pwbrophy/thundergeddon-kicad/TankHull/3d_models/MP2228GJ-Z.step

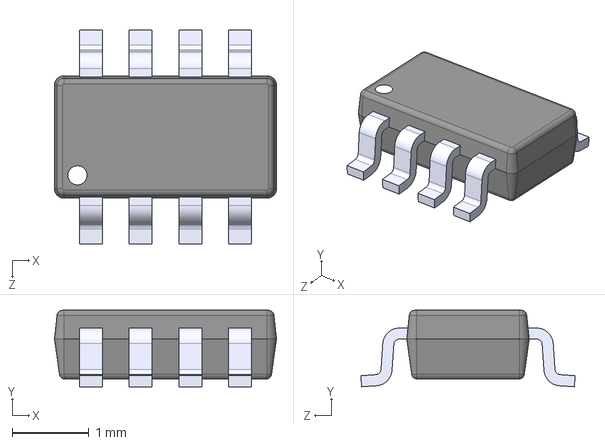
[picture p1: CAD file, 2026-01-02]
TankHull/3d_models/MP2228GJ-Z.step
2.90 x 1.00 x 2.80 mm
