pwbrophy/thundergeddon-kicad/TankHull/TankHull.step

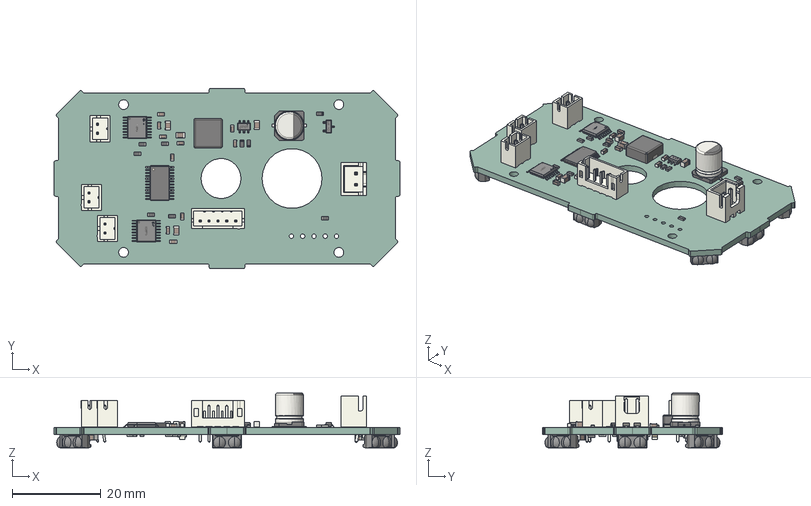
[picture p2: CAD file, 2026-03-31]
TankHull/TankHull.step
77.9 x 40.6 x 12.4 mm
JST_XH_B2B-XH-A_1x02_P2.50mm_Vertical
R_0603_1608Metric x 28
C_0805_2012Metric x 12
C_0603_1608Metric x 18
JST_PH_B2B-PH-K_1x02_P2.00mm_Vertical x 3
TSOT-23-6_L2.9-W1.6-H1.1-LS2.8-P0.95
SOT-23-3P_L2.9-W1.3-H1.0-LS2.4-P0.95
TSSOP-16_L5.0-W4.4-H1.0-LS6.4-P0.65 x 2
TSSOP-24_4.4x7.8mm_P0.65mm
JST_PH_B5B-PH-K_1x05_P2.00mm_Vertical
CP_Elec_6.3x7.7
L_Changjiang_FXL0630
IRM-V838M3_TR1 x 8
LED_0805_2012Metric
D_0603_1608Metric
TankHull_PCB
