pwbrophy/thundergeddon-kicad/TankHull/TankHull.kicad_pcb

## KiCad design TankHull/TankHull.kicad_pcb (2026-03-15)

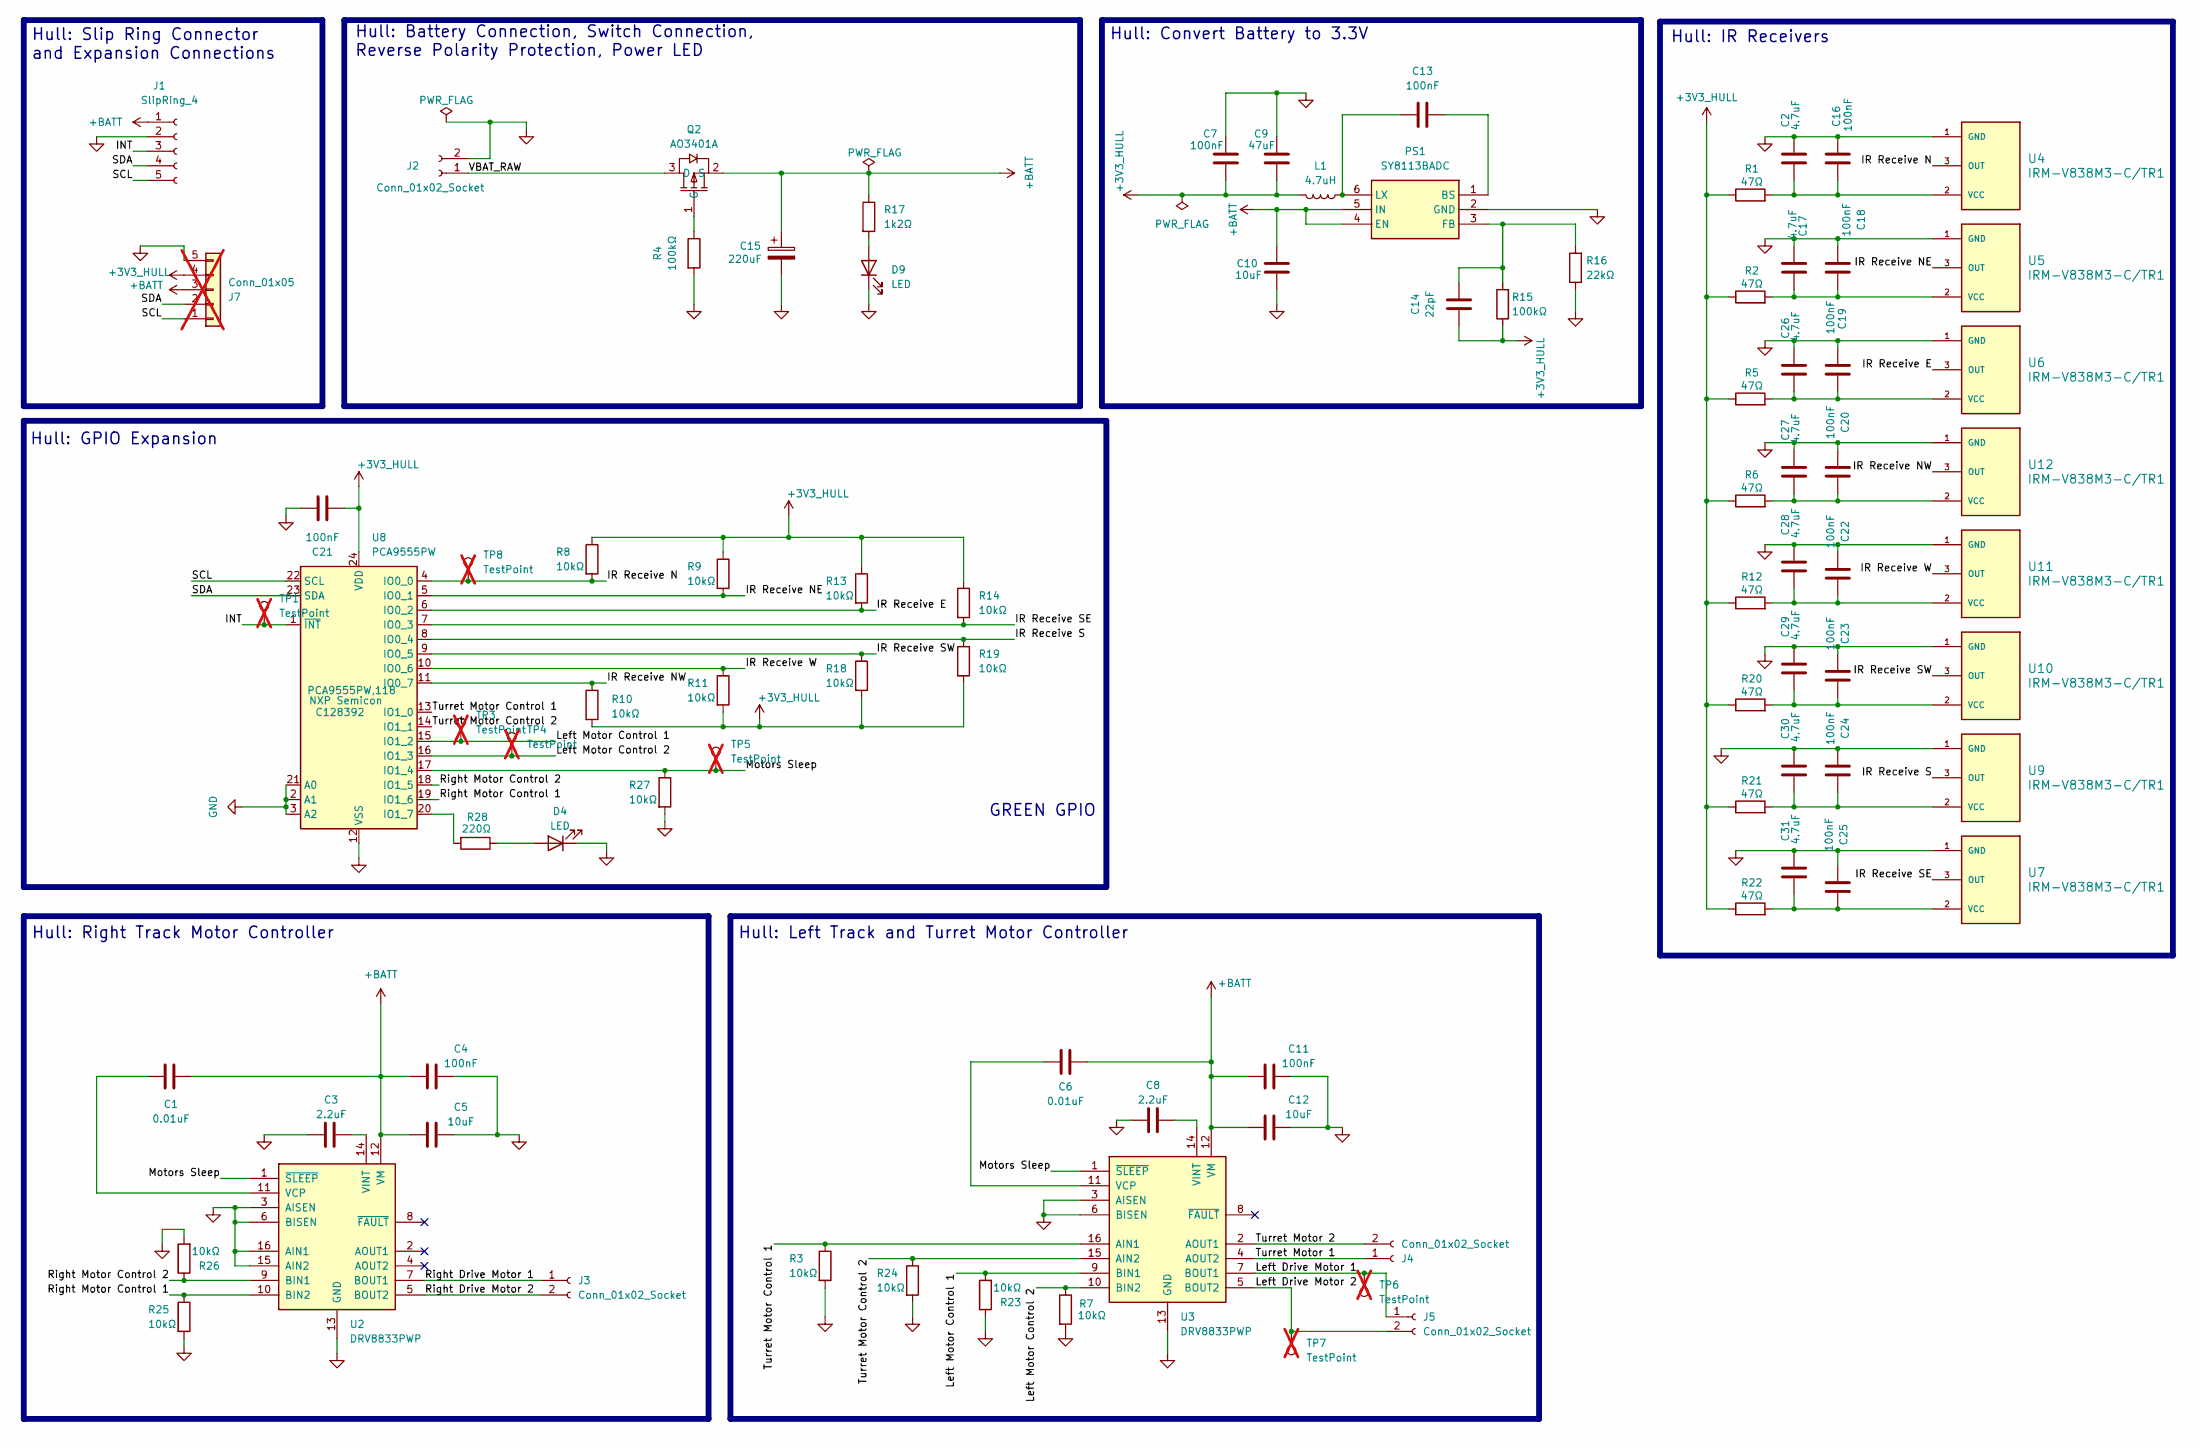
[picture p4: schematic TankHull.kicad_sch, Tank Hull Board]

Parts:
C1, C6: 0.01uF; C_0603_1608Metric; Manufacturer_Part_Number 0603B103K500NT; JLCPCB Part # C57112
C2, C17, C26, C27, C28, C29, C30, C31: 4.7uF; C_0805_2012Metric; JLCPCB Part # C1779
C3, C8: 2.2uF; C_0603_1608Metric; Manufacturer_Part_Number CL10A225KO8NNNC; JLCPCB Part # C23630
C4, C7, C11, C13, C16, C18, C19, C20, C21, C22, C23, C24, C25: 100nF; C_0603_1608Metric; Manufacturer_Part_Number CC0603KRX7R9BB104; JLCPCB Part # C14663
C5, C10, C12: 10uF; C_0805_2012Metric; Manufacturer_Part_Number CL21A106KAYNNNE; JLCPCB Part # C15850
C9: 47uF; C_0805_2012Metric; Manufacturer_Part_Number C16780; JLCPCB Part # C16780
C14: 22pF; C_0603_1608Metric; Manufacturer_Part_Number CL10C220JB8NNNC; JLCPCB Part # C1653
C15: 220uF; CP_Elec_6.3x7.7; Manufacturer_Part_Number RVT220UF16V67RV0015; JLCPCB Part # C2887273
D4: LED; LED_0805_2012Metric; JLCPCB Part # C2297
D9: LED; D_0603_1608Metric; Manufacturer_Part_Number KT-0603R; JLCPCB Part # C2286
J1: SlipRing_4; JST_PH_B5B-PH-K_1x05_P2.00mm_Vertical; JLCPCB Part # C157993
J2: Conn_01x02_Socket; JST_XH_B2B-XH-A_1x02_P2.50mm_Vertical; Manufacturer_Part_Number B2B-XH-A(LF)(SN); JLCPCB Part # C158012
J3, J4, J5: Conn_01x02_Socket; JST_PH_B2B-PH-K_1x02_P2.00mm_Vertical; Manufacturer_Part_Number B2B-PH-K-S(LF)(SN); JLCPCB Part # C131337
J7: Conn_01x05; PinSocket_1x05_P2.54mm_Vertical; Manufacturer_Part_Number 2.54-1*5PFemale; JLCPCB Part # C50950; not fitted
L1: 4.7uH; L_Changjiang_FXL0630; Manufacturer_Part_Number FXL0630-4R7-M; JLCPCB Part # C167220
PS1: SY8113BADC; SOT95P285X100-6N; Manufacturer_Part_Number SY8113BADC; JLCPCB Part # C78989
Q2: AO3401A; SOT-23_L2.9-W1.3-P1.90-LS2.4-BR; JLCPCB Part # C15127
R1, R2, R5, R6, R12, R20, R21, R22: 47Ω; R_0603_1608Metric; JLCPCB Part # C23182
R3, R7, R8, R9, R10, R11, R13, R14, R18, R19, R23, R24, R25, R26, R27: 10kΩ; R_0603_1608Metric; Manufacturer_Part_Number 0603WAF1002T5E; JLCPCB Part # C25804
R4, R15: 100kΩ; R_0603_1608Metric; Manufacturer_Part_Number 0603WAF1003T5E; JLCPCB Part # C25803
R16: 22kΩ; R_0603_1608Metric; Manufacturer_Part_Number 0603WAF2202T5E; JLCPCB Part # C31850
R17: 1k2Ω; R_0603_1608Metric; Manufacturer_Part_Number 0603WAF1201T5E; JLCPCB Part # C22765
R28: 220Ω; R_0603_1608Metric; JLCPCB Part # C22962
TP1, TP3, TP4, TP5, TP6, TP7, TP8: TestPoint; TestPoint_Pad_D1.0mm; not fitted
U2, U3: DRV8833PWP; HTSSOP-16-1EP_4.4x5mm_P0.65mm_EP3.4x5mm_Mask2.46x2.31mm_The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; Manufacturer_Part_Number DRV8833PWPR; JLCPCB Part # C50506
U4, U5, U6, U7, U9, U10, U11, U12: IRM-V838M3-C/TR1; XDCR_IRM-V838M3_TR1; PARTREV 7; JLCPCB Part # C3291489
U8: PCA9555PW; TSSOP-24_4.4x7.8mm_P0.65mm; Manufacturer_Part_Number PCA9555PW,118; JLCPCB Part # C128392

Connections:
+3V3_HULL: C7.1, C9.1, C14.2, C21.2, J7.4, L1.2, R1.1, R2.1, R5.1, R6.1, R8.1, R9.1, R10.2, R11.2, R12.1, R13.1, R14.1, R15.1, R18.2, R19.2, R20.1, R21.1, R22.1, U8.24 (VDD)
+BATT: C1.1, C4.2, C5.2, C6.1, C10.2, C11.2, C12.2, C15.1, J1.1, J7.3, PS1.4 (EN), PS1.5 (IN), Q2.2 (S), R17.1, U2.12 (VM), U3.12 (VM)
/INT: J1.3, TP1.1, U8.1 (~INT)
/IR Receive E: R13.2, U6.3 (OUT), U8.6 (IO0_2)
/IR Receive N: R8.2, TP8.1, U4.3 (OUT), U8.4 (IO0_0)
/IR Receive NE: R9.2, U5.3 (OUT), U8.5 (IO0_1)
/IR Receive NW: R10.1, U8.11 (IO0_7), U12.3 (OUT)
/IR Receive S: R19.1, U8.8 (IO0_4), U9.3 (OUT)
/IR Receive SE: R14.2, U7.3 (OUT), U8.7 (IO0_3)
/IR Receive SW: R18.1, U8.9 (IO0_5), U10.3 (OUT)
/IR Receive W: R11.1, U8.10 (IO0_6), U11.3 (OUT)
/Left Drive Motor 1: J5.1, TP6.1, U3.7 (BOUT1)
/Left Drive Motor 2: J5.2, TP7.1, U3.5 (BOUT2)
/Left Motor Control 1: R23.2, TP3.1, U3.9 (BIN1), U8.15 (IO1_2)
/Left Motor Control 2: R7.1, TP4.1, U3.10 (BIN2), U8.16 (IO1_3)
/Motors Sleep: R27.1, TP5.1, U2.1 (~SLEEP), U3.1 (~SLEEP), U8.17 (IO1_4)
/Right Drive Motor 1: J3.1, U2.7 (BOUT1)
/Right Drive Motor 2: J3.2, U2.5 (BOUT2)
/Right Motor Control 1: R25.1, U2.10 (BIN2), U8.19 (IO1_6)
/Right Motor Control 2: R26.1, U2.9 (BIN1), U8.18 (IO1_5)
/SCL: J1.5, J7.1, U8.22 (SCL)
/SDA: J1.4, J7.2, U8.23 (SDA)
/Turret Motor 1: J4.1, U3.4 (AOUT2)
/Turret Motor 2: J4.2, U3.2 (AOUT1)
/Turret Motor Control 1: R3.1, U3.16 (AIN1), U8.13 (IO1_0)
/Turret Motor Control 2: R24.1, U3.15 (AIN2), U8.14 (IO1_1)
/VBAT_RAW: J2.1, Q2.3 (D)
GND: C2.1, C3.1, C4.1, C5.1, C7.2, C8.1, C9.2, C10.1, C11.1, C12.1, C15.2, C16.1, C17.1, C18.1, C19.1, C20.1, C21.1, C22.1, C23.1, C24.1, C25.1, C26.1, C27.1, C28.1, C29.1, C30.1, C31.1, D4.1 (K), D9.1 (K), J1.2, J2.2, J7.5, PS1.2 (GND), R3.2, R4.2, R7.2, R16.1, R23.1, R24.2, R25.2, R26.2, R27.2, U2.3 (AISEN), U2.6 (BISEN), U2.13 (GND), U2.15 (AIN2), U2.16 (AIN1), U2.17 (GND), U3.3 (AISEN), U3.6 (BISEN), U3.13 (GND), U3.17 (GND), U4.1 (GND), U4.4 (GND), U5.1 (GND), U5.4 (GND), U6.1 (GND), U6.4 (GND), U7.1 (GND), U7.4 (GND), U8.2 (A1), U8.3 (A2), U8.12 (VSS), U8.21 (A0), U9.1 (GND), U9.4 (GND), U10.1 (GND), U10.4 (GND), U11.1 (GND), U11.4 (GND), U12.1 (GND), U12.4 (GND)
unnamed: D4.2 (A), R28.1
unnamed: D9.2 (A), R17.2
unnamed: C13.1, PS1.1 (BS)
unnamed: C14.1, PS1.3 (FB), R15.2, R16.2
unnamed: C13.2, L1.1, PS1.6 (LX)
unnamed: Q2.1 (G), R4.1
unnamed: C1.2, U2.11 (VCP)
unnamed: C3.2, U2.14 (VINT)
unnamed: C6.2, U3.11 (VCP)
unnamed: C8.2, U3.14 (VINT)
unnamed: C2.2, C16.2, R1.2, U4.2 (VCC)
unnamed: C17.2, C18.2, R2.2, U5.2 (VCC)
unnamed: C19.2, C26.2, R5.2, U6.2 (VCC)
unnamed: C25.2, C31.2, R22.2, U7.2 (VCC)
unnamed: R28.2, U8.20 (IO1_7)
unnamed: C24.2, C30.2, R21.2, U9.2 (VCC)
unnamed: C23.2, C29.2, R20.2, U10.2 (VCC)
unnamed: C22.2, C28.2, R12.2, U11.2 (VCC)
unnamed: C20.2, C27.2, R6.2, U12.2 (VCC)

Notes on the sheet:
GREEN GPIO
Hull: Left Track and Turret Motor Controller
Hull: Convert Battery to 3.3V
Hull: Slip Ring Connector and Expansion Connections
Hull: IR Receivers
Hull: Battery Connection, Switch Connection, Reverse Polarity Protection, Power LED
Hull: GPIO Expansion
Hull: Right Track Motor Controller

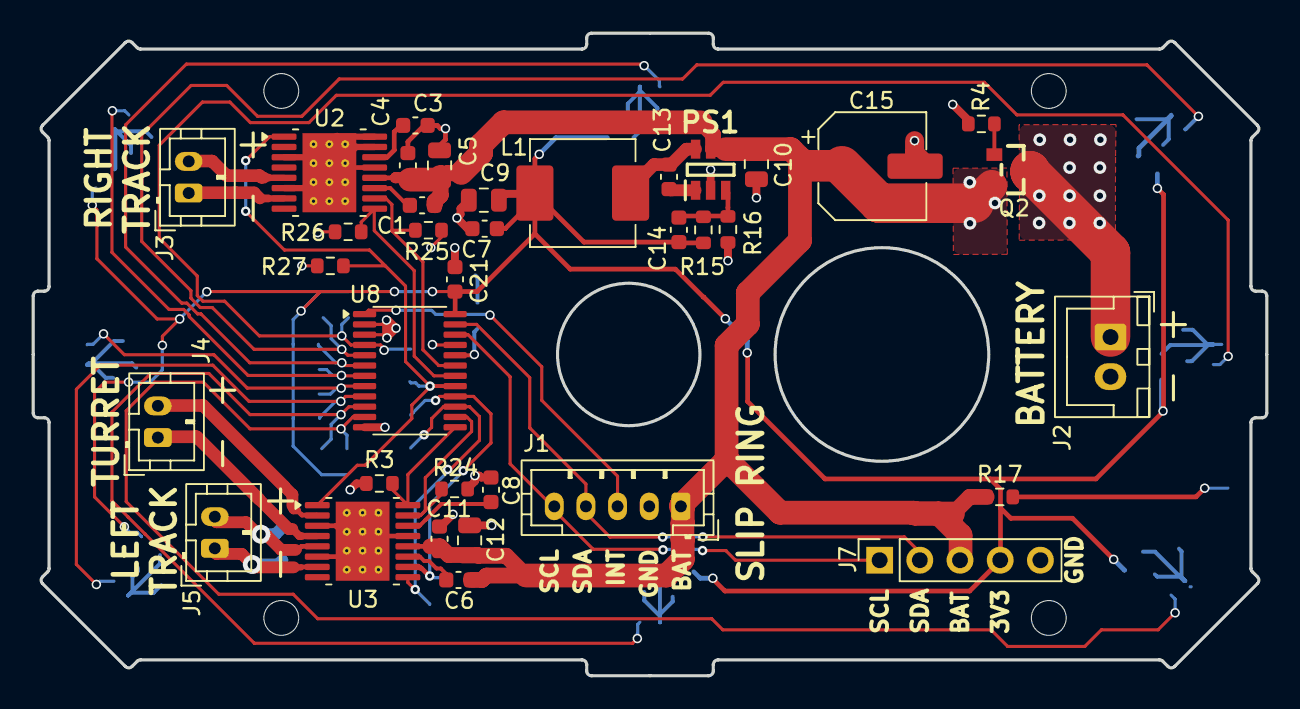
[picture p5: board TankHull.kicad_pcb from above]

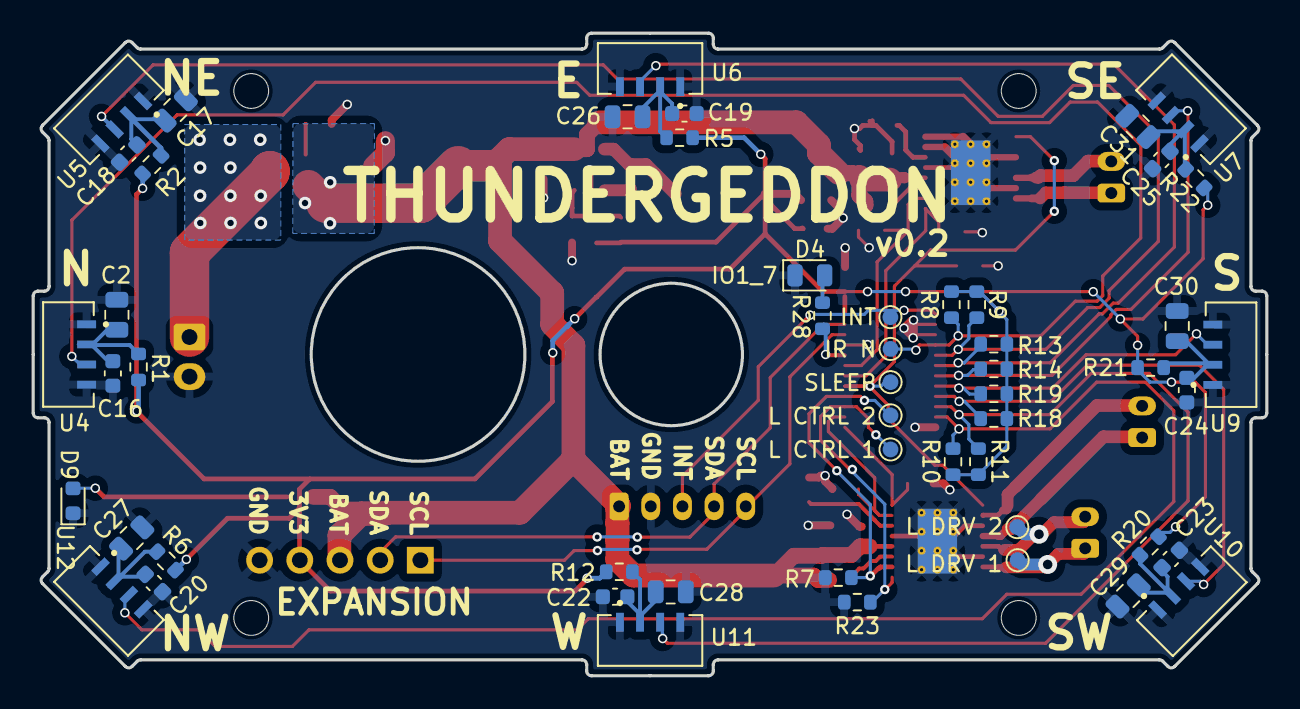
[picture p6: board TankHull.kicad_pcb from below]

Board: 2 copper layers, 77.9 x 40.6 mm, 88 parts (52 on the bottom side), 47 nets.
