pwbrophy/thundergeddon-kicad/TankTurret/TankTurret.kicad_pcb

## KiCad design TankTurret/TankTurret.kicad_pcb (2026-03-15)

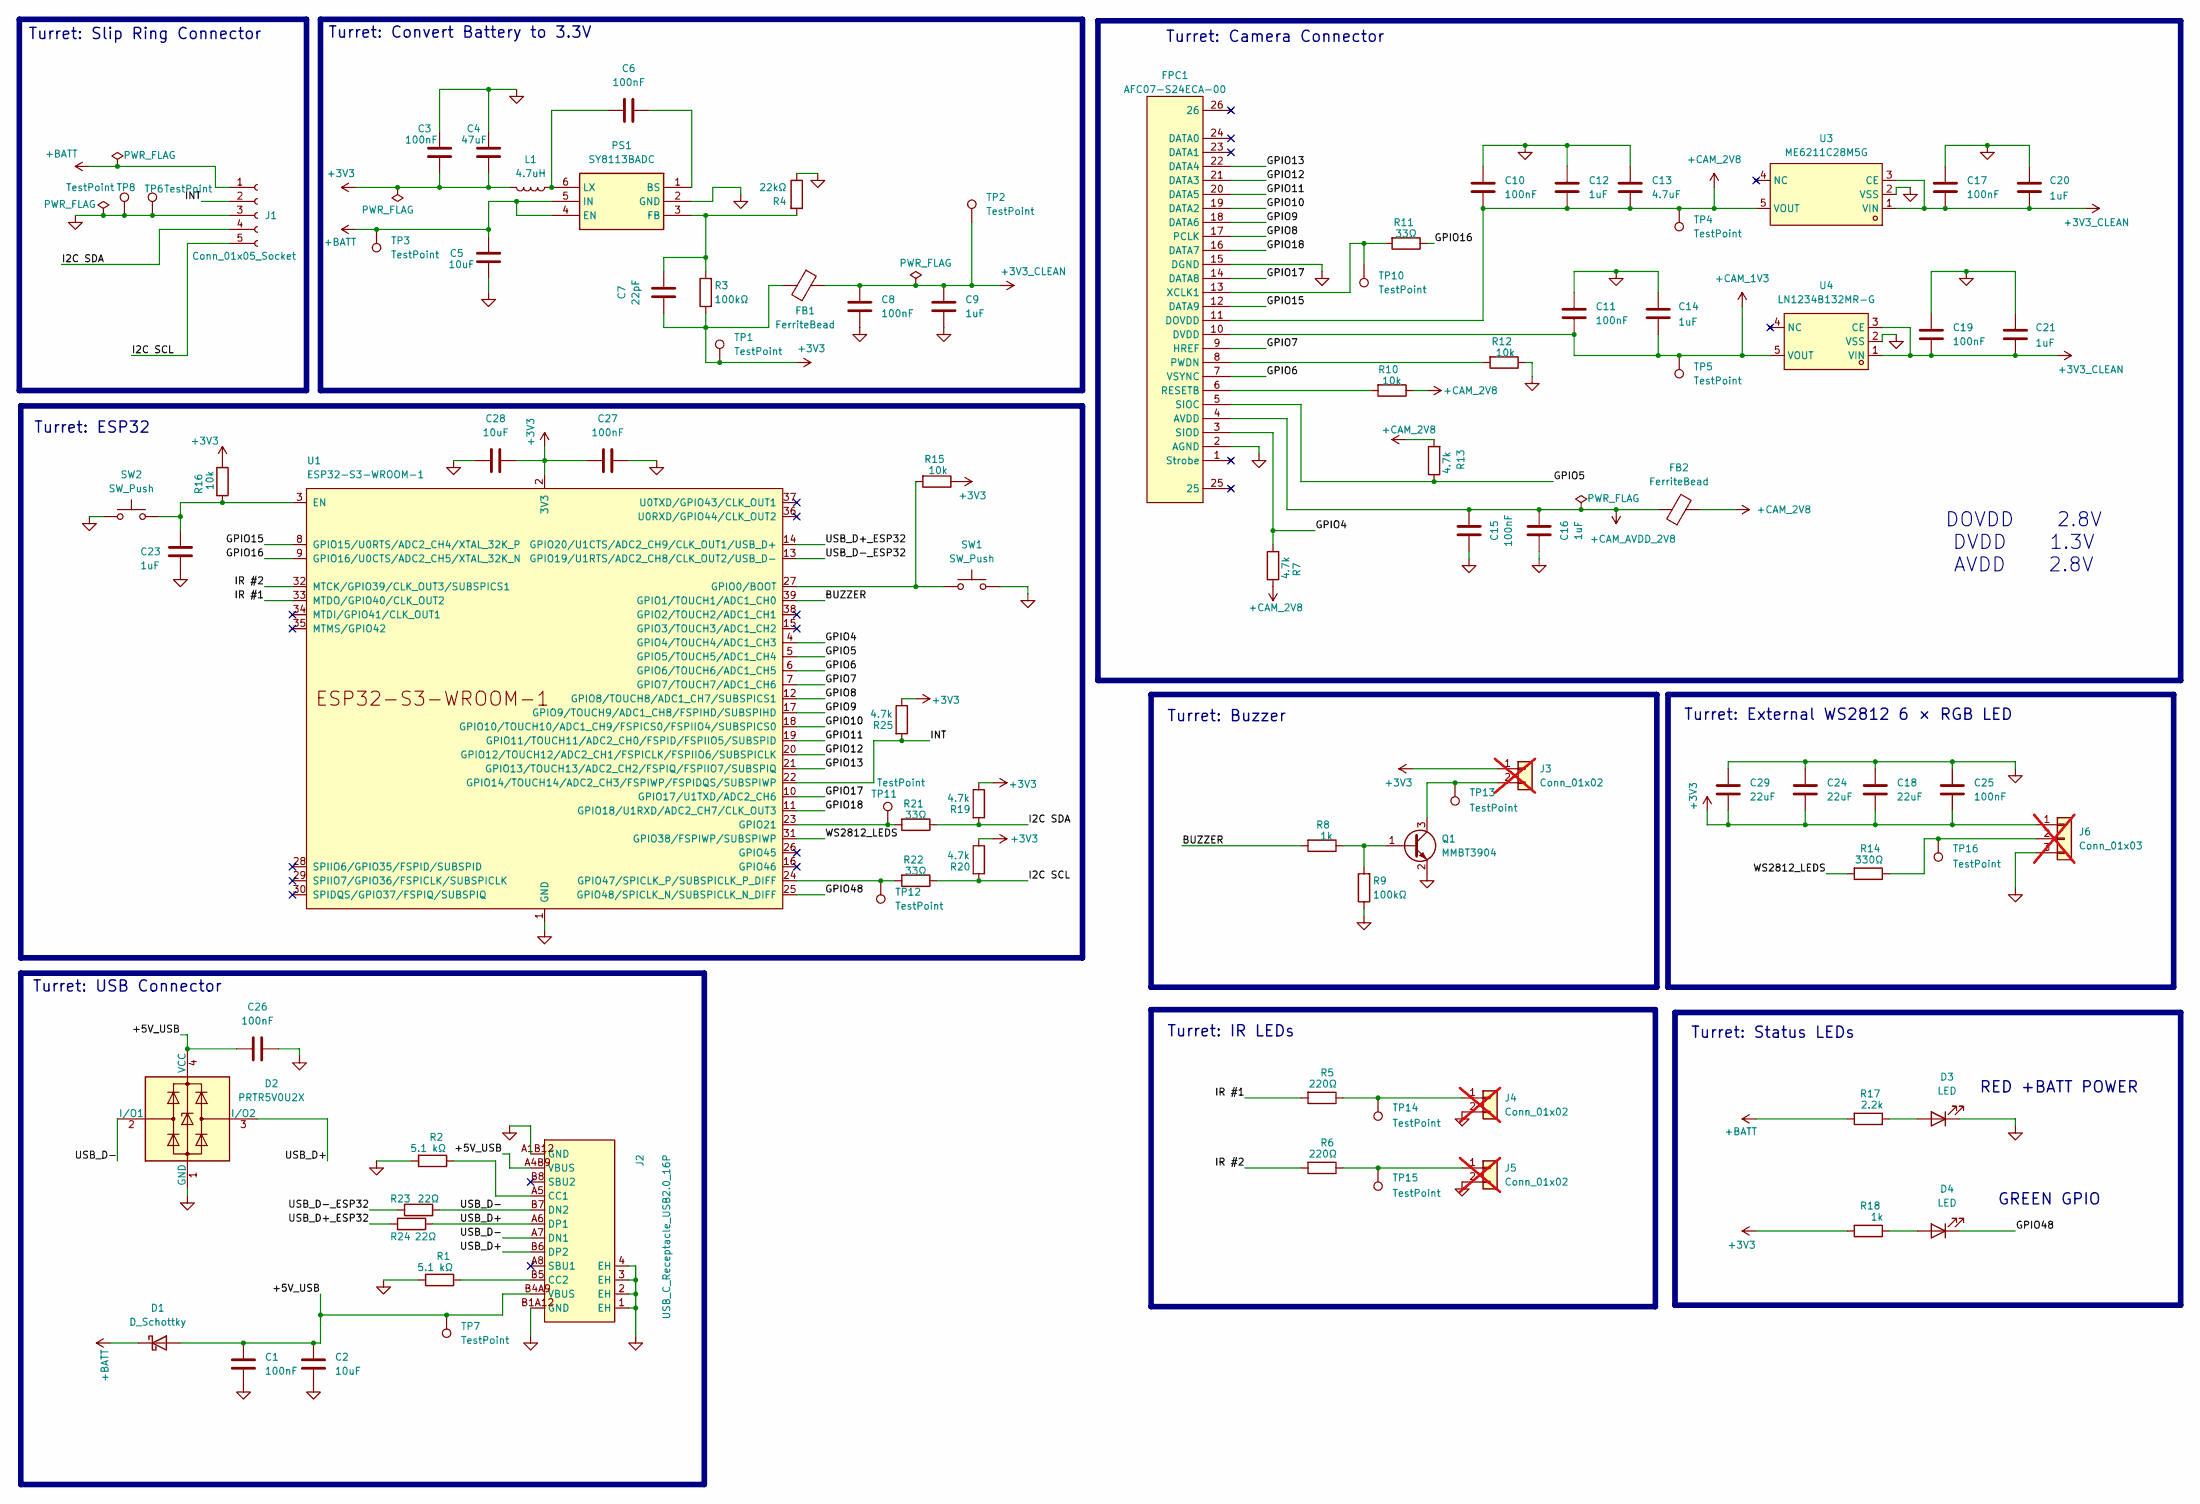
[picture p7: schematic TankTurret.kicad_sch]

Parts:
C1, C8, C15, C25, C26, C27: 100nF; C_0603_1608Metric; JLCPCB Part # C14663
C2, C28: 10uF; C_0805_2012Metric; JLCPCB Part # C15850
C3, C6: 100nF; C_0603_1608Metric; Manufacturer_Part_Number CC0603KRX7R9BB104; JLCPCB Part # C14663
C4: 47uF; C_0805_2012Metric; Manufacturer_Part_Number C16780; JLCPCB Part # C16780
C5: 10uF; C_0805_2012Metric; Manufacturer_Part_Number CL21A106KAYNNNE; JLCPCB Part # C15850
C7: 22pF; C_0603_1608Metric; Manufacturer_Part_Number CL10C220JB8NNNC; JLCPCB Part # C1653
C9, C12, C14, C16, C20, C21, C23: 1uF; C_0603_1608Metric; JLCPCB Part # C15849
C10, C11, C17, C19: 100nF; C_0402_1005Metric; JLCPCB Part # C1525
C13: 4.7uF; C_0805_2012Metric; JLCPCB Part # C1779
C18, C24, C29: 22uF; C_0805_2012Metric; Manufacturer_Part_Number CL21A226MAQNNNE; JLCPCB Part # C45783
D1: D_Schottky; D_SOD-123; Manufacturer_Part_Number B5819W SL; JLCPCB Part # C8598
D2: PRTR5V0U2X; SOT-143; JLCPCB Part # C5180302
D3: LED; LED_0603_1608Metric; JLCPCB Part # C2286
D4: LED; LED_0805_2012Metric; JLCPCB Part # C2297
FB1, FB2: FerriteBead; L_0603_1608Metric; JLCPCB Part # C1002
FPC1: AFC07-S24ECA-00; FPC-SMD_AFC07-S24ECA-00; LCSC Part C262643
J1: Conn_01x05_Socket; JST_PH_S5B-PH-K_1x05_P2.00mm_Horizontal; JLCPCB Part # C157923
J2: USB_C_Receptacle_USB2.0_16P; USB-C_SMD-TYPE-C-31-M-12_1; Manufacturer_Part_Number TYPE-C-31-M-12; JLCPCB Part # C165948
J3, J4, J5: Conn_01x02; PinHeader_1x02_P2.54mm_Vertical; not fitted
J6: Conn_01x03; PinHeader_1x03_P2.54mm_Vertical; not fitted
L1: 4.7uH; L_Changjiang_FXL0630; Manufacturer_Part_Number FXL0630-4R7-M; JLCPCB Part # C167220
PS1: SY8113BADC; SOT95P285X100-6N; Manufacturer_Part_Number SY8113BADC; JLCPCB Part # C78989
Q1: MMBT3904; SOT-23; Manufacturer_Part_Number MMBT3904(RANGE:100-300); JLCPCB Part # C20526
R1, R2: 5.1 kΩ; R_0603_1608Metric; JLCPCB Part # C23186
R3, R9: 100kΩ; R_0603_1608Metric; Manufacturer_Part_Number 0603WAF1003T5E; JLCPCB Part # C25803
R4: 22kΩ; R_0603_1608Metric; Manufacturer_Part_Number 0603WAF2202T5E; JLCPCB Part # C31850
R5, R6: 220Ω; R_0603_1608Metric; JLCPCB Part # C22962
R7, R13, R19, R20, R25: 4.7k; R_0603_1608Metric; JLCPCB Part # C23162
R8, R18: 1k; R_0603_1608Metric; JLCPCB Part # C21190
R10, R12, R15, R16: 10k; R_0603_1608Metric; JLCPCB Part # C25804
R11: 33Ω; R_0603_1608Metric; JLCPCB Part # C23140
R14: 330Ω; R_0603_1608Metric; JLCPCB Part # C23138
R17: 2.2k; R_0603_1608Metric; JLCPCB Part # C4190
R21, R22: 33Ω; R_0402_1005Metric; JLCPCB Part # C25105
R23, R24: 22Ω; R_0402_1005Metric; JLCPCB Part # C25092
SW1, SW2: SW_Push; SW_Push_1P1T_XKB_TS-1187A; Manufacturer_Part_Number TS-1187A-B-A-B; JLCPCB Part # C318884
TP1, TP2, TP3, TP4, TP5, TP6, TP7, TP8, TP10, TP11, TP12, TP13, TP14, TP15, TP16: TestPoint; TestPoint_Pad_D1.0mm
U1: ESP32-S3-WROOM-1; ESP32-S3-WROOM-1U; Manufacturer_Part_Number ESP32-S3-WROOM-1U-N16R8; JLCPCB Part # C3013946
U3: ME6211C28M5G; SOT-23-5; Manufacturer_Part_Number ME6211C28M5G-N; LCSC Part C53099
U4: LN1234B132MR-G; SOT-23-5; Manufacturer_Part_Number LN1234B132MR-G; LCSC Part C3008051

Connections:
+3V3: C3.1, C4.1, C7.2, C18.2, C24.2, C25.2, C27.2, C28.2, C29.2, FB1.2, J3.1, J6.1, L1.2, R3.1, R15.1, R16.1, R18.2, R19.1, R20.1, R25.1, TP1.1, U1.2 (3V3)
+3V3_CLEAN: C8.1, C9.1, C17.2, C19.2, C20.2, C21.2, FB1.1, TP2.1, U3.1 (VIN), U3.3 (CE), U4.1 (VIN), U4.3 (CE)
+BATT: C5.2, D1.1 (K), J1.1, PS1.4 (EN), PS1.5 (IN), R17.2, TP3.1
+CAM_1V3: C11.2, C14.2, FPC1.10 (DVDD), TP5.1, U4.5 (VOUT)
+CAM_2V8: C10.2, C12.2, C13.2, FB2.2, FPC1.11 (DOVDD), R7.1, R10.1, R13.2, TP4.1, U3.5 (VOUT)
+CAM_AVDD_2V8: C15.1, C16.1, FB2.1, FPC1.4 (AVDD)
/+5V_USB: C1.1, C2.1, C26.2, D1.2 (A), D2.4 (VCC), J2.A4B9 (VBUS), J2.B4A9 (VBUS), TP7.1
/BUZZER: R8.2, U1.39 (GPIO1/TOUCH1/ADC1_CH0)
/GPIO4: FPC1.3 (SIOD), R7.2, U1.4 (GPIO4/TOUCH4/ADC1_CH3)
/GPIO5: FPC1.5 (SIOC), R13.1, U1.5 (GPIO5/TOUCH5/ADC1_CH4)
/GPIO6: FPC1.7 (VSYNC), U1.6 (GPIO6/TOUCH6/ADC1_CH5)
/GPIO7: FPC1.9 (HREF), U1.7 (GPIO7/TOUCH7/ADC1_CH6)
/GPIO8: FPC1.17 (PCLK), U1.12 (GPIO8/TOUCH8/ADC1_CH7/SUBSPICS1)
/GPIO9: FPC1.18 (DATA6), U1.17 (GPIO9/TOUCH9/ADC1_CH8/FSPIHD/SUBSPIHD)
/GPIO10: FPC1.19 (DATA2), U1.18 (GPIO10/TOUCH10/ADC1_CH9/FSPICS0/FSPIIO4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)
/GPIO11: FPC1.20 (DATA5), U1.19 (GPIO11/TOUCH11/ADC2_CH0/FSPID/FSPIIO5/S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)
/GPIO12: FPC1.21 (DATA3), U1.20 (GPIO12/TOUCH12/ADC2_CH1/FSPICLK/FSPIIO6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)
/GPIO13: FPC1.22 (DATA4), U1.21 (GPIO13/TOUCH13/ADC2_CH2/FSPIQ/FSPIIO7/S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)
/GPIO15: FPC1.12 (DATA9), U1.8 (GPIO15/U0RTS/ADC2_CH4/XTAL_32K_P)
/GPIO16: R11.1, U1.9 (GPIO16/U0CTS/ADC2_CH5/XTAL_32K_N)
/GPIO17: FPC1.14 (DATA8), U1.10 (GPIO17/U1TXD/ADC2_CH6)
/GPIO18: FPC1.16 (DATA7), U1.11 (GPIO18/U1RXD/ADC2_CH7/CLK_OUT3)
/GPIO48: D4.1 (K), U1.25 (GPIO48/SPICLK_N/SUBSPICLK_N_DIFF)
/I2C SCL: J1.5, R20.2, R22.1
/I2C SDA: J1.4, R19.2, R21.1
/INT: J1.2, R25.2, U1.22 (GPIO14/TOUCH14/ADC2_CH3/FSPIWP/FSPIDQS/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)
/IR #1: R5.2, U1.33 (MTDO/GPIO40/CLK_OUT2)
/IR #2: R6.2, U1.32 (MTCK/GPIO39/CLK_OUT3/SUBSPICS1)
/USB_D+: D2.3 (I/O2), J2.A6 (DP1), J2.B6 (DP2), R24.1
/USB_D+_ESP32: R24.2, U1.14 (GPIO20/U1CTS/ADC2_CH9/CLK_OUT1/USB_D+)
/USB_D-: D2.2 (I/O1), J2.A7 (DN1), J2.B7 (DN2), R23.2
/USB_D-_ESP32: R23.1, U1.13 (GPIO19/U1RTS/ADC2_CH8/CLK_OUT2/USB_D-)
/WS2812_LEDS: R14.2, U1.31 (GPIO38/FSPIWP/SUBSPIWP)
GND: C1.2, C2.2, C3.2, C4.2, C5.1, C8.2, C9.2, C10.1, C11.1, C12.1, C13.1, C14.1, C15.2, C16.2, C17.1, C18.1, C19.1, C20.1, C21.1, C23.1, C24.1, C25.1, C26.1, C27.1, C28.1, C29.1, D2.1 (GND), D3.1 (K), FPC1.2 (AGND), FPC1.15 (DGND), J1.3, J2.1 (EH), J2.2 (EH), J2.3 (EH), J2.4 (EH), J2.A1B12 (GND), J2.B1A12 (GND), J4.2, J5.2, J6.3, PS1.2 (GND), Q1.2 (E), R1.2, R2.2, R4.1, R9.1, R12.1, SW1.2, SW2.1, TP6.1, TP8.1, U1.1 (GND), U1.40 (GND), U1.41 (GND), U3.2 (VSS), U4.2 (VSS)
unnamed: D3.2 (A), R17.1
unnamed: D4.2 (A), R18.1
unnamed: FPC1.8 (PWDN), R12.2
unnamed: FPC1.6 (RESETB), R10.2
unnamed: FPC1.13 (XCLK1), R11.2, TP10.1
unnamed: J2.A5 (CC1), R2.1
unnamed: J2.B5 (CC2), R1.1
unnamed: J3.2, Q1.3 (C), TP13.1
unnamed: J4.1, R5.1, TP14.1
unnamed: J5.1, R6.1, TP15.1
unnamed: J6.2, R14.1, TP16.1
unnamed: C6.1, PS1.1 (BS)
unnamed: C7.1, PS1.3 (FB), R3.2, R4.2
unnamed: C6.2, L1.1, PS1.6 (LX)
unnamed: Q1.1 (B), R8.1, R9.2
unnamed: C23.2, R16.2, SW2.2, U1.3 (EN)
unnamed: R15.2, SW1.1, U1.27 (GPIO0/BOOT)
unnamed: R21.2, TP11.1, U1.23 (GPIO21)
unnamed: R22.2, TP12.1, U1.24 (GPIO47/SPICLK_P/SUBSPICLK_P_DIFF)

Notes on the sheet:
DOVDD 2.8V DVDD 1.3V AVDD 2.8V
Turret: USB Connector
Turret: IR LEDs
Turret: ESP32
Turret: Camera Connector
Turret: Slip Ring Connector
Turret: Convert Battery to 3.3V
Turret: Buzzer
RED +BATT POWER
Turret: Status LEDs
GREEN GPIO
Turret: External WS2812 6 × RGB LED

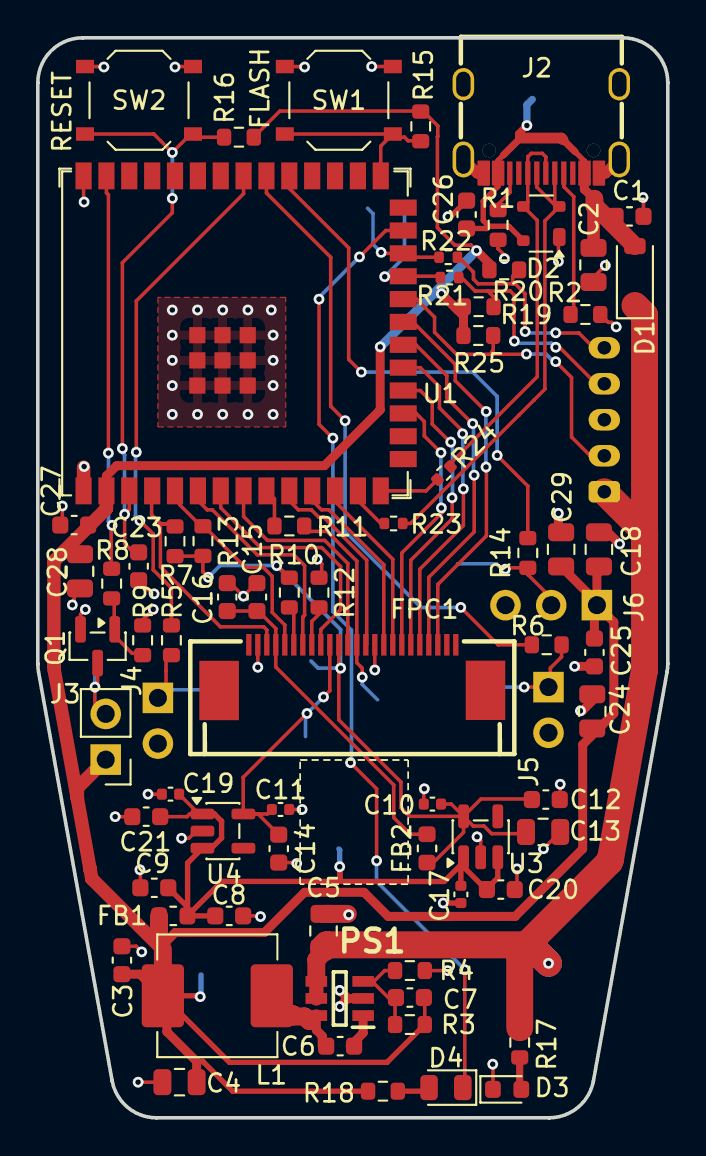
[picture p8: board TankTurret.kicad_pcb from above]

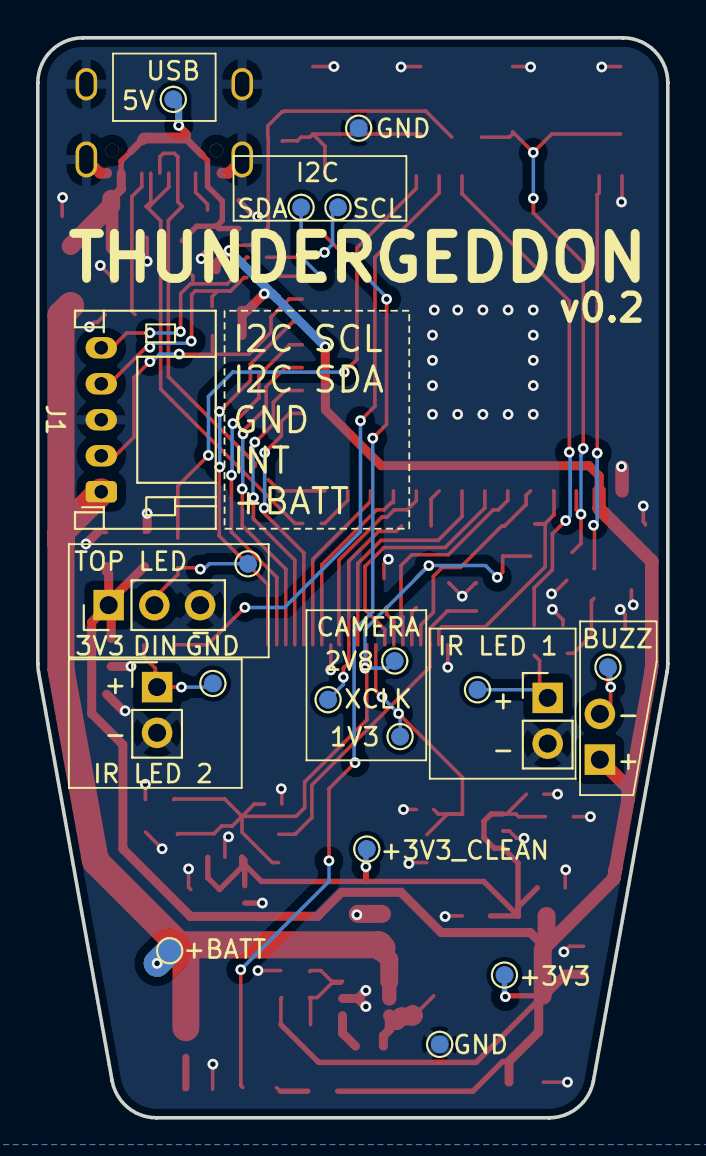
[picture p9: board TankTurret.kicad_pcb from below]

Board: 2 copper layers, 35.0 x 60.0 mm, 89 parts (19 on the bottom side), 53 nets.
