pwbrophy/thundergeddon-kicad/(commit log)

2026-01-02 First upload!
    [MP2228GJ-Z.step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]
2026-01-04 began IR receiver update on hull board
    [TankHull.kicad_pcb, TankHull.kicad_sch]
2026-01-05 continue with ir receiver update
    [TankHull.kicad_pcb, TankHull.kicad_sch]
2026-01-07 continued with IR receiver update
    [TankHull.kicad_pcb, TankHull.kicad_sch]
2026-01-09 submit before using cleanup tool
    [TankHull.kicad_pcb, TankHull.kicad_sch]
2026-01-16 camera connector
    [TankHull.kicad_pcb, TankHull.kicad_sch, TankTurret.kicad_pcb, TankTurret.kicad_sch]
2026-03-15 V0.2 Files sent to JLC PCB on 15/03/2026
    [TankHull.csv, TankHull.kicad_pcb, TankHull.kicad_sch, TankTurret.csv, TankTurret.kicad_pcb, TankTurret.kicad_sch, bom.csv, designators.csv]
